KoulmS/fichier-annexe-epareuse/shema elec v2epareuse nunchuk_bb.png

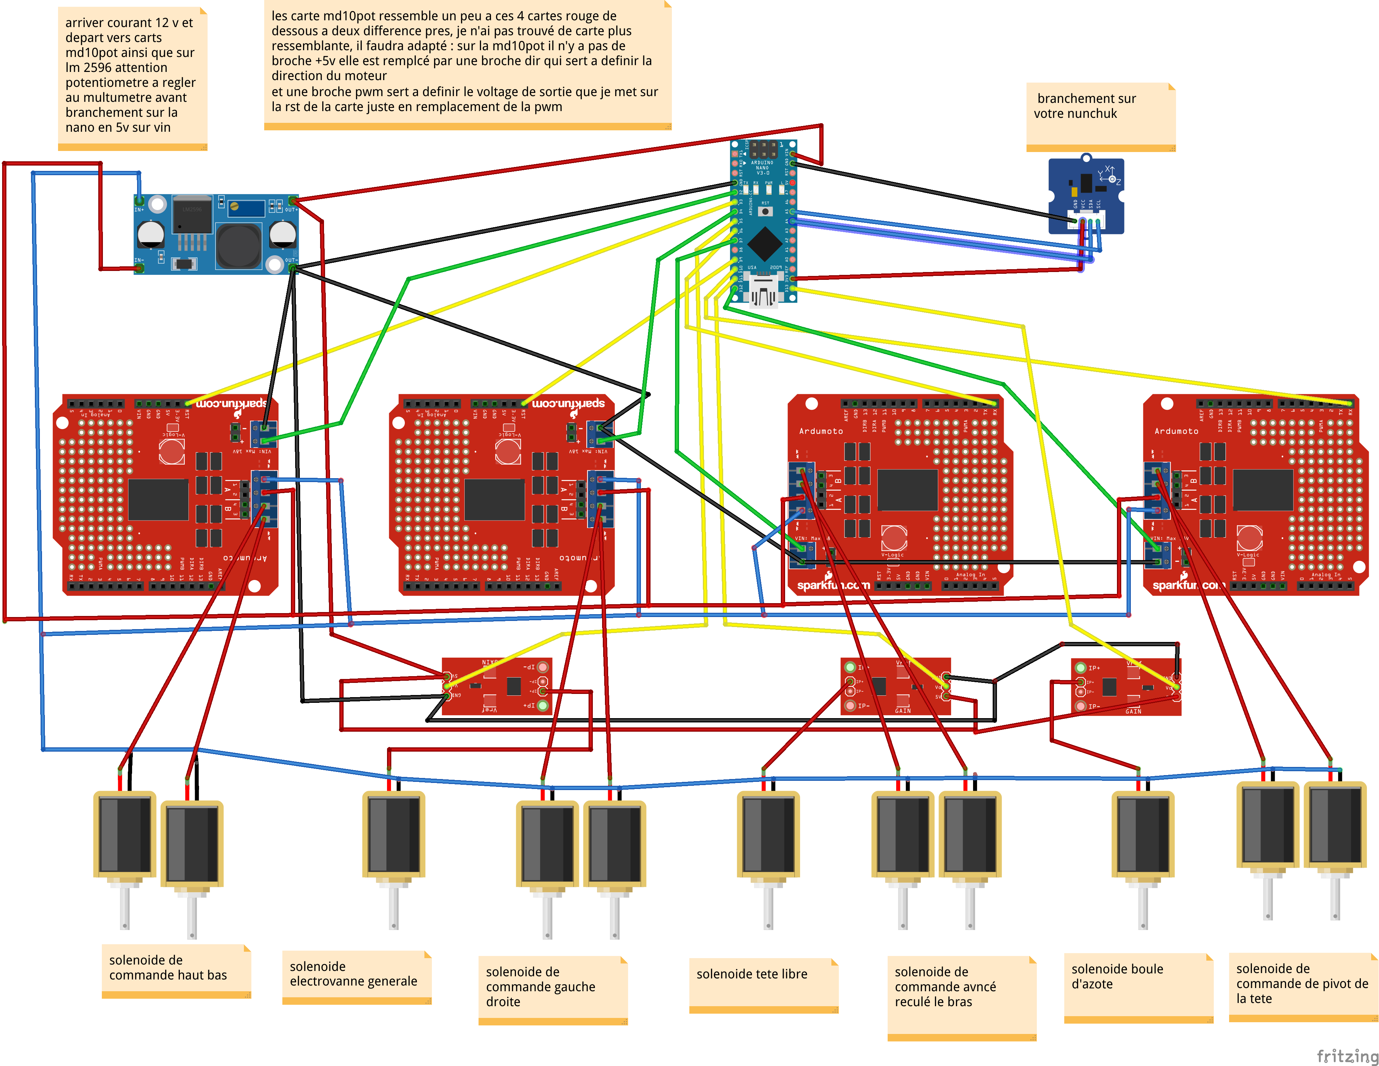
shema elec v2epareuse nunchuk_bb.png
