KoulmS/fichier-annexe-epareuse/(list of files, drawings)

Other design files:
shema electrique epareuse nunchuk.fzz
